MaximNaessens/LineFollower/readme.md

# LineFollower
<br />
lege repository die je als template kan gebruiken om een eigen repository te starten voor uw linefollower project
<br />
<br />
FOTO AUTO V2
<br />
<br />
  
## specifications
<br />
microcontroller: STM32F103C8T6
<br />
motors: 50:1 micro metal gearmotor HP 6V
<br />
h-bridge: DRV8833
<br />
sensors: QTR-8A
<br />
batteries: 18650 batterij x2
<br />
wireless communication: HC-05
<br />
distance sensor - motors: 9 cm
<br />
weight: zonder batterijen: 181g
<br />
weight: met batterijen: 270g
<br />
speed: 0,412 m/s
<br />
