MaximNaessens/LineFollower/code/proof of concepts/sensor/readme.md

# Sensoren proof of concept

De voeding is via een USB kabel
