MaximNaessens/LineFollower/technische tekeningen/elektronisch/PlanB.pdf

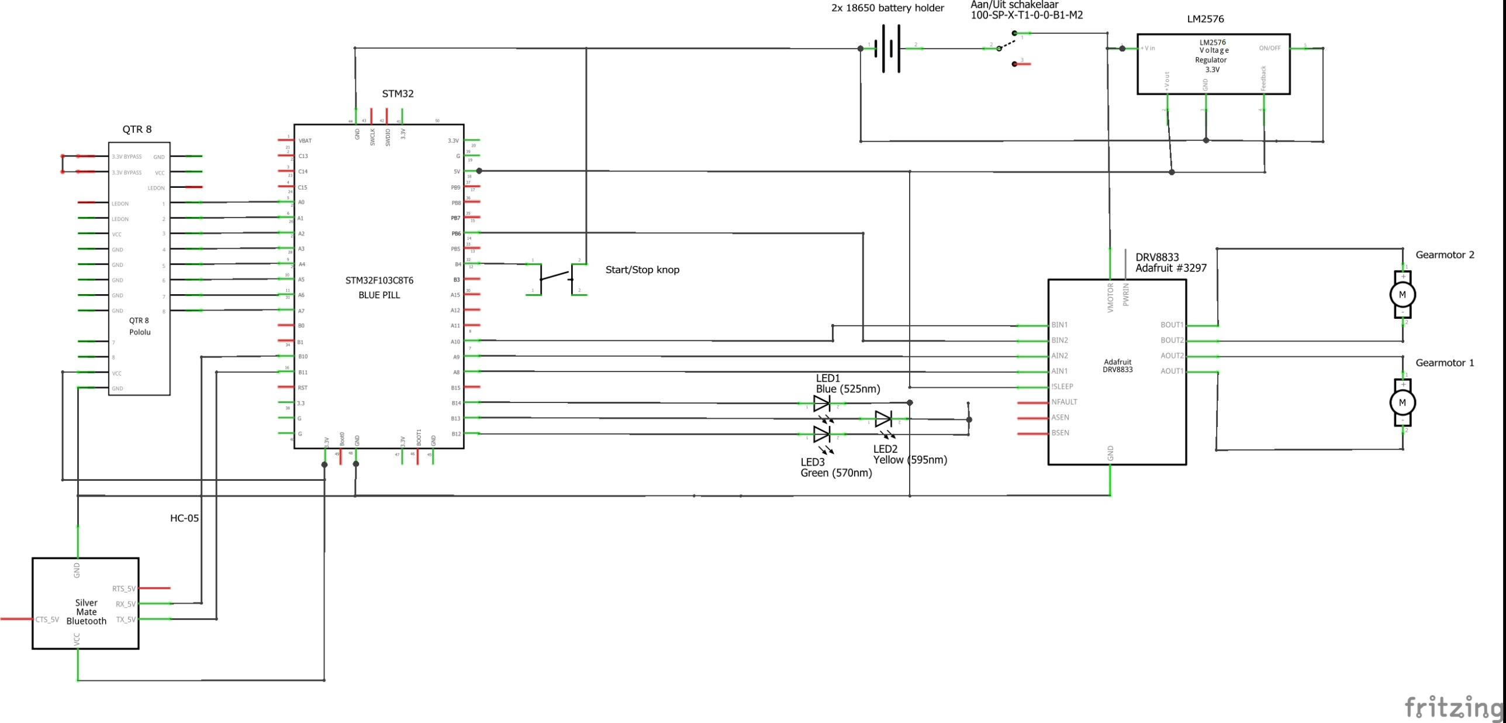
[picture p1: page 1]
