MaximNaessens/LineFollower/code/proof of concepts/hbridge/H-brug schema.png

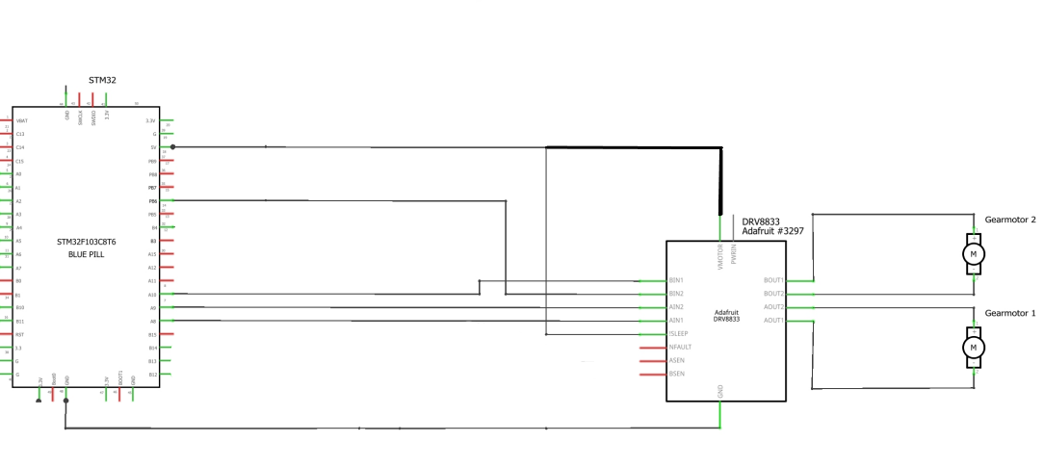
code/proof of concepts/hbridge/H-brug schema.png
