MaximNaessens/LineFollower/code/proof of concepts/sensor/schema_SENSOR.png

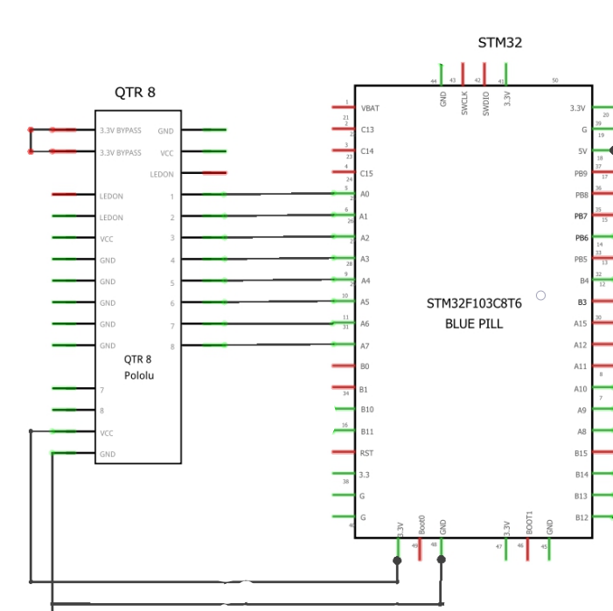
code/proof of concepts/sensor/schema_SENSOR.png
