MaximNaessens/LineFollower/bill of materials/BOM Maxim Naessens.pdf

Naam | Aantal Stukprijs Link
QTR-8A Reflectance Sensor Array | 1 € 13,65 QTR-8A (https://opencircuit.be/product/qtr-8a-reflectance-sensor-array)
STM32F103C8T6 | 1 € 11,99 STM32 (https://www.dennisdeal.com/products/stm32f103c8t6-arm-stm32-kleine-systeemontwikkeling-board-module-scm-core-board_1668936)
DRV8833 | 1 € | 7,95 DRV8833 (https://www.gotron.be/adafruit-drv8833-dc-stepper-motor-driver-breakout-board.html)
Breadboard 400 points | 1 € | 3,00 Breadboard (https://www.tinytronics.nl/shop/nl/gereedschap-en-montage/prototyping-toebehoren/breadboards/breadboard-400-points)
2x 18650 batterij houder | 1 € | 1,50 Batterijhouder (https://www.tinytronics.nl/shop/nl/power/batterijhouders-en-clips/18650/2x-18650-batterij-houder-met-losse-draden)
2x 18650 batterijen met oplader | 1 € 22,95 Batterijen+oplader (https://www.bol.com/be/nl/p/2x-quickstuff-18650-batterijen-plus-oplader-combipack/9200000102580397/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)
bluetooth HC-05 module | 1 € 16,00 HC-05 (https://www.tinytronics.nl/shop/nl/communicatie-en-signalen/draadloos/bluetooth/modules/bluetooth-hc-05-module-rf-transceiver-master-en-slave)
LM2576 5V regelaar | 1 € | 2,85 Voltregelaar (https://be.farnell.com/microchip/lm2576-5-0wt/buck-40vin-52khz-3a-5v-5to220/dp/2509860)
50:1 Micro metal gearmotor HP 6V | 2 € 21,60 Gearmotor (https://opencircuit.be/product/50-1-micro-metal-gearmotor-hpcb-6v-extended)
Polulu wielen 40x7mm | 1 € | 4,90 Wielen (https://opencircuit.be/product/pololu-wiel-40-7mm-wit-2-stuks)
Polulu Micro metal gearmotor bracket pair | 1 € | 4,50 Brackets (https://opencircuit.be/product/micro-metal-gearmotor-bracket-pair-black)
Dupont jumper draad female-female 10cm 10 draden | 1 € | 0,50 Draden1 (https://www.tinytronics.nl/shop/nl/kabels-en-connectoren/kabels-en-adapters/prototyping-draden/dupont-compatible-en-jumper/dupont-jumper-draad-female-female-1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)
Dupont jumper draad male-female 20m 10 draden | 1 € | 0,75 Draden2 (https://www.tinytronics.nl/shop/nl/kabels-en-connectoren/kabels-en-adapters/prototyping-draden/dupont-compatible-en-jumper/dupont-jumper-draad-male-female-20c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)
Dupont jumper draad male-male 10cm 10 daden | 1 € | 0,50 Draden3 (https://www.tinytronics.nl/shop/nl/kabels-en-connectoren/kabels-en-adapters/prototyping-draden/dupont-compatible-en-jumper/dupont-jumper-draad-male-male-10cm-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)
40 pins header male | 1 € | 0,40 connectorrij (https://www.tinytronics.nl/shop/nl/kabels-en-connectoren/connectoren/pin-headers/male/40-pins-header-male)
Plexiglas helder 5mm dik | 1 € 27,77 Plexiglas (https://kunststofplaten.be/product/plexiglas-helder-gs-5-mm/)
dubbelzijdige kleefband | 1 € | 4,89 Tape (https://www.hubo.be/nl/p/tesa-dubbelzijdige-kleefband-5m-x-50mm-geel/40249.html)
soldeertin 1mm | 1 € 21,90 Soldeertin (https://www.bol.com/nl/nl/p/100g-soldeertin-1mm/9200000086361689/)
krimpkos 2:1 (diameter 3mm, 50cm lang) | 1 € | 0,60 Krimpkous (https://www.tinytronics.nl/shop/nl/gereedschap-en-montage/installatie-en-montagemateriaal/krimpkousen/krimpkous-2:1-%C3%B8-3mm-diameter-50cm)
gele LED (5mm diffuus) | 1 € | 0,10 Gele LED (https://www.tinytronics.nl/shop/nl/componenten/led's/led's/gele-led-5mm-diffuus)
tuimelschakelaar | 1 € | 0,80 Tuimelschakelaar (https://www.tinytronics.nl/shop/nl/schakelaars/manuele-schakelaars/tuimelschakelaars/standaard-inbouw-tuimelschakelaar-mts-113)
Pushbutton switch 4 pin 6x6x5mm | 1 € | 0,10 Pushbutton (https://www.tinytronics.nl/shop/nl/schakelaars/manuele-schakelaars/printplaatschakelaars/tactile-pushbutton-switch-momentary-4pin-6*6*5mm)
TOTAAL | € 190,90
